AlexGyver/Auto_Pump_Sleep/README.md

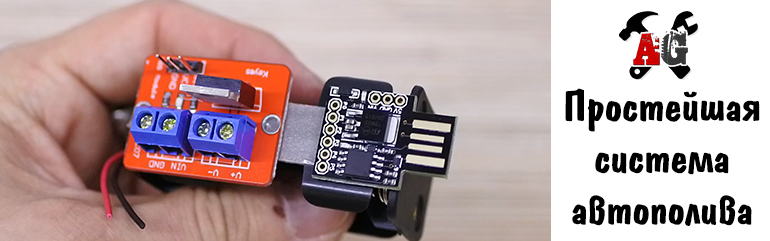
[picture p1: proj_img.jpg]
PROJECT_PHOTO

# Простейшая система авто полива
* [Описание проекта](#chapter-0)
* [Папки проекта](#chapter-1)
* [Схемы подключения](#chapter-2)
* [Материалы и компоненты](#chapter-3)
* [Как скачать и прошить](#chapter-4)
* [FAQ](#chapter-5)
* [Полезная информация](#chapter-6)
AlexGyver YouTube (https://www.youtube.com/channel/UCgtAOyEQdAyjvm9ATCi_Aig?sub_confirmation=1)

## Описание проекта
Автополив на Digispark
Особенности:
- Простейшая схема: мосфет модуль и помпа
- Режим глубокого энрегосбережения: 30 мкА в режиме сна
- Недорогая платформа Digispark
- Подробности в видео: https://youtu.be/x6ProAzvT1g

## Папки
**ВНИМАНИЕ! Если это твой первый опыт работы с Arduino, читай [инструкцию](#chapter-4)**
- **libraries** - библиотеки проекта
- **digi_pump** - прошивка из видео
- **digi_servo_sleep** - прошивка для серво (не забудьте установить библиотеку)
- **schemes** - схемы подключения

## Схемы
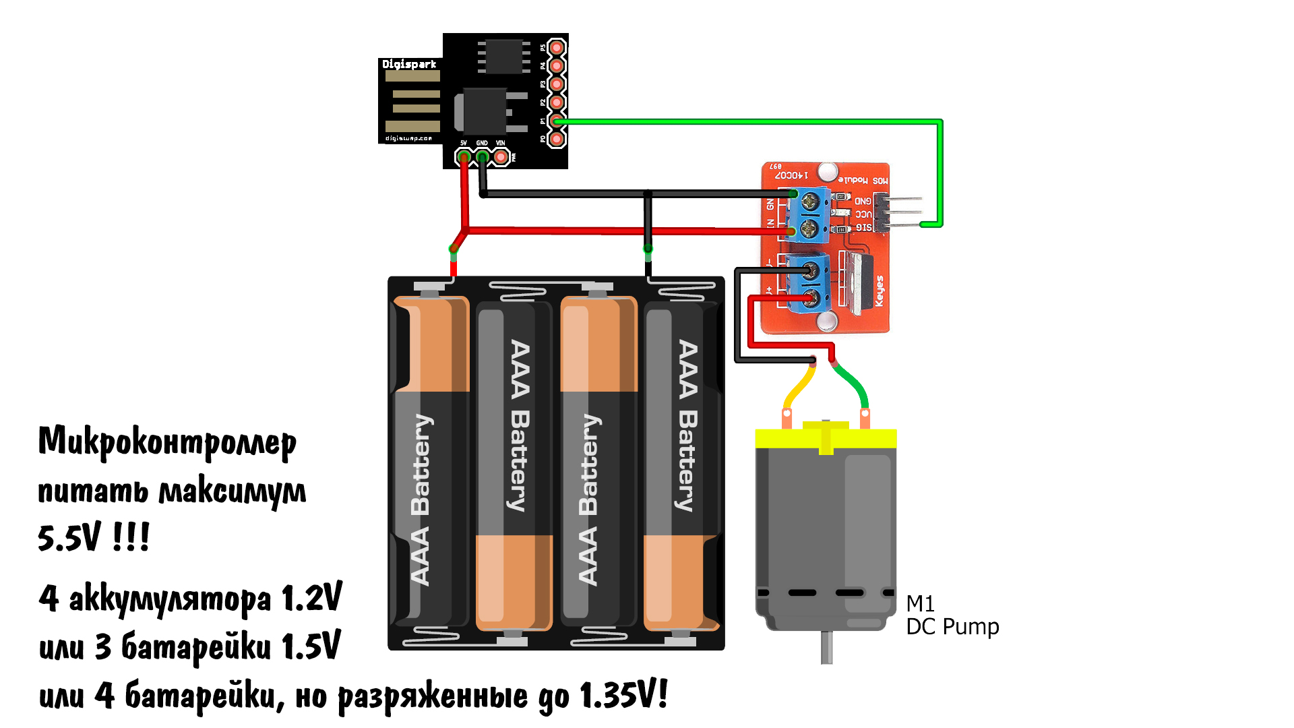
[picture p2: schemes/scheme1.jpg]
SCHEME

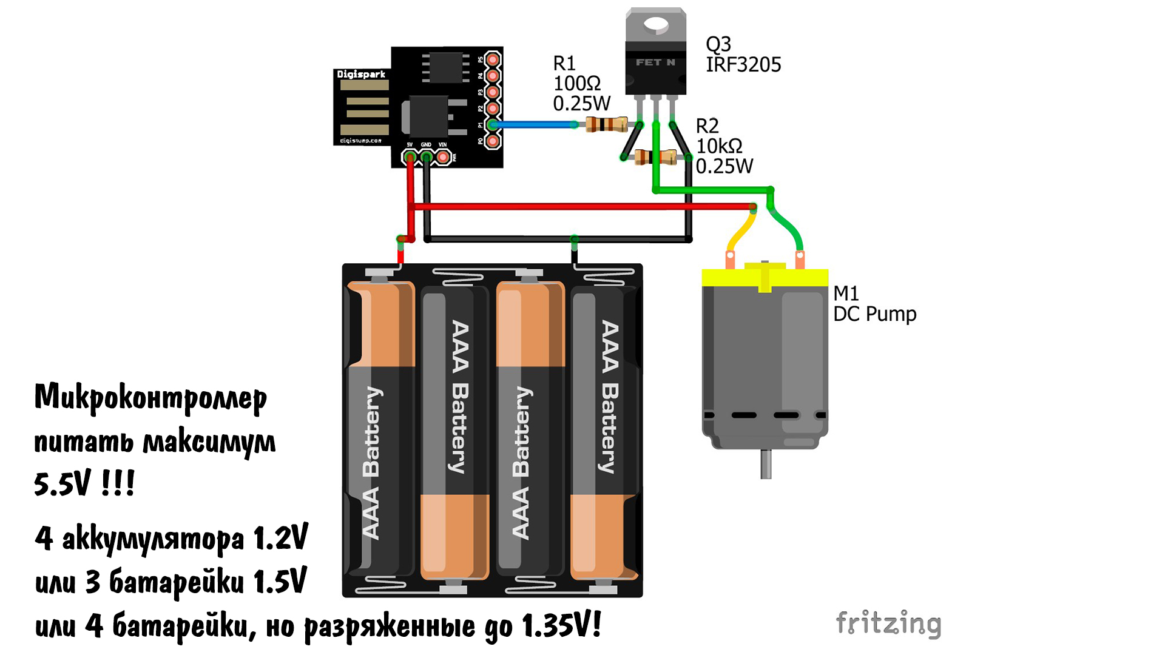
[picture p3: schemes/scheme2.jpg]
SCHEME

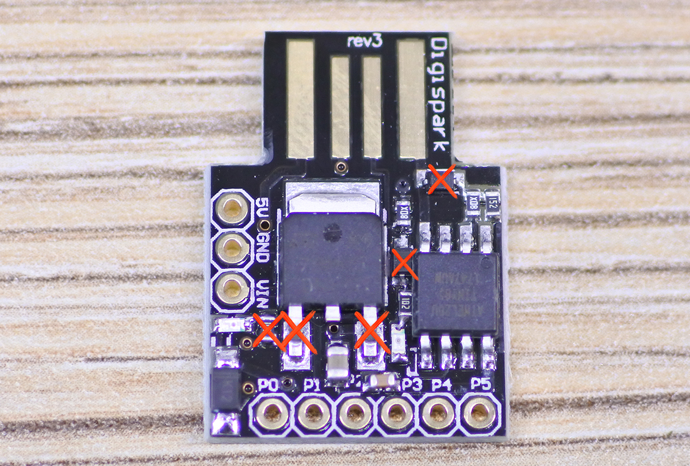
[picture p4: schemes/modif.jpg]
SCHEME


## Материалы и компоненты
### Ссылки оставлены на магазины, с которых я закупаюсь уже не один год
### Почти все компоненты можно взять в магазине WAVGAT по первым ссылкам
* Digispark https://ali.ski/3ZJtu
* Мосфет модуль https://ali.ski/Tb75N6
* Батарейный отсек 4xAA https://ali.ski/xfc4R4
* Отсек 3-4 АА (другой магаз) https://ali.ski/PoAge3
* Отсек как на видео (другой магаз) https://ali.ski/x8dByd
* Помпа https://ali.ski/yVOHbe
* Транзисторы, конденсаторы и резисторы – в ЛЮБОМ магазине радиодеталей
* Шланг https://ali.ski/Laapo4
* Тройнички https://ali.ski/xaXXo
* Разветвитель https://ali.ski/Wmn3R

## Вам скорее всего пригодится
* [Всё для пайки (паяльники и примочки)](http://alexgyver.ru/all-for-soldering/)
* [Недорогие инструменты](http://alexgyver.ru/my_instruments/)
* [Все существующие модули и сенсоры Arduino](http://alexgyver.ru/arduino_shop/)
* [Электронные компоненты](http://alexgyver.ru/electronics/)
* [Аккумуляторы и зарядные модули](http://alexgyver.ru/18650/)

## Как скачать и прошить
* [Первые шаги с Arduino](http://alexgyver.ru/arduino-first/) - ультра подробная статья по началу работы с Ардуино, ознакомиться первым делом!
* Скачать архив с проектом
> На главной странице проекта (где ты читаешь этот текст) вверху справа зелёная кнопка **Clone or download**, вот её жми, там будет **Download ZIP**
* Установить библиотеки в  
`C:\Program Files (x86)\Arduino\libraries\` (Windows x64)  
`C:\Program Files\Arduino\libraries\` (Windows x86)
* Подключить Ардуино к компьютеру
* Запустить файл прошивки (который имеет расширение .ino)
* Настроить IDE (COM порт, модель Arduino, как в статье выше)
* Настроить что нужно по проекту
* Нажать загрузить
* Пользоваться  

## Настройки в коде
    #define PERIOD 5       // период работы в секундах
    #define WORK 5         // время работы в секундах
    #define MOS 1          // пин мосфета

## FAQ
### Основные вопросы
В: Как скачать с этого грёбаного сайта?  
О: На главной странице проекта (где ты читаешь этот текст) вверху справа зелёная кнопка **Clone or download**, вот её жми, там будет **Download ZIP**

В: Скачался какой то файл .zip, куда его теперь?  
О: Это архив. Можно открыть стандартными средствами Windows, но думаю у всех на компьютере установлен WinRAR, архив нужно правой кнопкой и извлечь.

В: Я совсем новичок! Что мне делать с Ардуиной, где взять все программы?  
О: Читай и смотри видос http://alexgyver.ru/arduino-first/

В: Вылетает ошибка загрузки / компиляции!
О: Читай тут: https://alexgyver.ru/arduino-first/#step-5

В: Сколько стоит?  
О: Ничего не продаю.

### Вопросы по этому проекту

## Полезная информация
* [Мой сайт](http://alexgyver.ru/)
* [Основной YouTube канал](https://www.youtube.com/channel/UCgtAOyEQdAyjvm9ATCi_Aig?sub_confirmation=1)
* [YouTube канал про Arduino](https://www.youtube.com/channel/UC4axiS76D784-ofoTdo5zOA?sub_confirmation=1)
* [Мои видеоуроки по пайке](https://www.youtube.com/playlist?list=PLOT_HeyBraBuMIwfSYu7kCKXxQGsUKcqR)
* [Мои видеоуроки по Arduino](http://alexgyver.ru/arduino_lessons/)
