AlexGyver/Auto_Pump_Sleep/schemes/scheme0.jpg

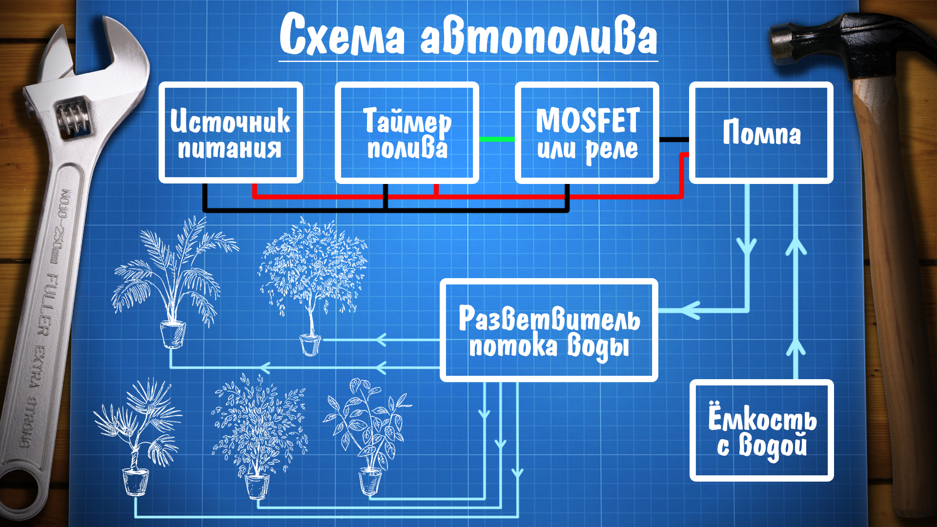
schemes/scheme0.jpg
