AlexGyver/Auto_Pump_Sleep/(threads)

Thread 1 (2018-06-03):

Добавить конденсатор в рекомендации

SilverFire, 2018-06-03:
Стартовый ток помпы доходит до 1.5А, и если источник питания недостаточно резвый, напряжение просаживается и контроллер перезагружается. Добавление 200 мкФ емкости по линии питания решает эту проблему.

SlimRG, 2019-03-18:
> Стартовый ток помпы доходит до 1.5А, и если источник питания недостаточно резвый, напряжение просаживается и контроллер перезагружается. Добавление 200 мкФ емкости по линии питания решает эту проблему.

Можете поподробней: какой конденсатор и куда пихать?

SilverFire, 2019-03-18:
Конденсатор на 10V ёмкостью 200мкФ и больше. Чем слабее источник питания и чем больше насосов – тем большая нужна ёмкость. У меня 2 мотора работают от аккумулятора 18650 с конденсатором на 10V 220мкФ. Пихать как обычный фильтрующий конденсатор: параллельно линии питания.

SlimRG, 2019-03-18:
@SilverFire Мне его пихать на промежутке от мосфета к помпе или от аккума к мосфету?

SilverFire, 2019-03-20:
Не, в промежуток – это последовательно, а нужно параллельно.

Вот так:

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

SlimRG, 2019-04-19:
@SilverFire а как быть,  если схема - мосфет

И второй вопрос,  можно ли взять конденсатор на 3300 форады (не сгорит ли дигиспарк)

SilverFire, 2019-04-22:
В то же самое место: возле входа питания на микроконтроллер

SlimRG, 2019-06-03:
> В то же самое место: возле входа питания на микроконтроллер

Так?
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

SilverFire, 2019-06-03:
Да, именно так :)
